HomeSpan/SomfyPlus/(commit log)

2022-02-06 Updated sketch version to 2.1.0 and added "const" to "char *" to prevent warning during compilation
    [DEV_Somfy.h, SomfyPlus.ino]
2022-05-28 Changed version number to 2.2.0
    Also added in explicit call to setStatusPin(13) since this is not longer the default in current versions of HomeSpan.
